amichaelparker/rack-mount/rack_mount_FL_V2.stl

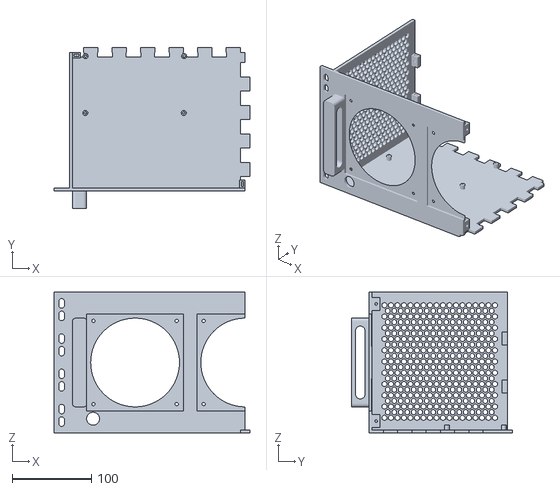
[picture p1: CAD file, 2026-07-29]
rack_mount_FL_V2.stl
247.3 x 203.0 x 177.8
