amichaelparker/rack-mount/rack_mount_GPU_BAR.stl

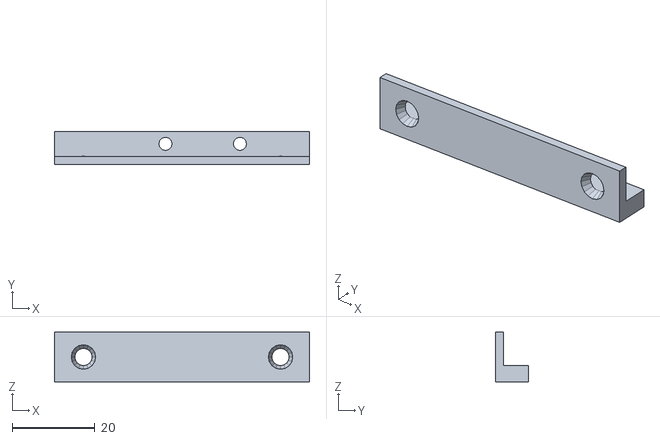
[picture p2: CAD file, 2026-07-29]
rack_mount_GPU_BAR.stl
61.6 x 8.00 x 12.0
