amichaelparker/rack-mount/rack_mount_FL.stl

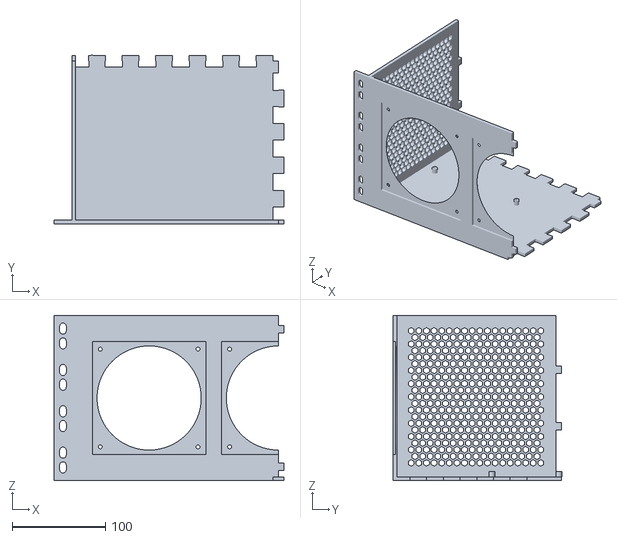
[picture p3: CAD file, 2026-07-29]
rack_mount_FL.stl
247.3 x 181.6 x 177.8
