amichaelparker/rack-mount/rack_mount_jig_L.stl

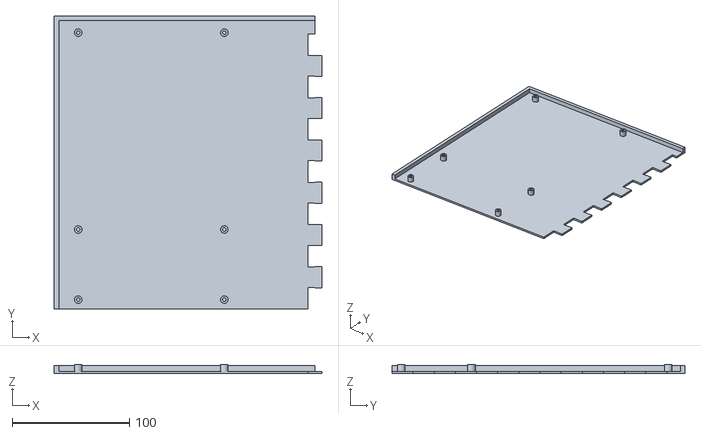
[picture p4: CAD file, 2026-07-29]
rack_mount_jig_L.stl
228.0 x 249.5 x 8.00
