amichaelparker/rack-mount/rack_mount_RL_V2.stl

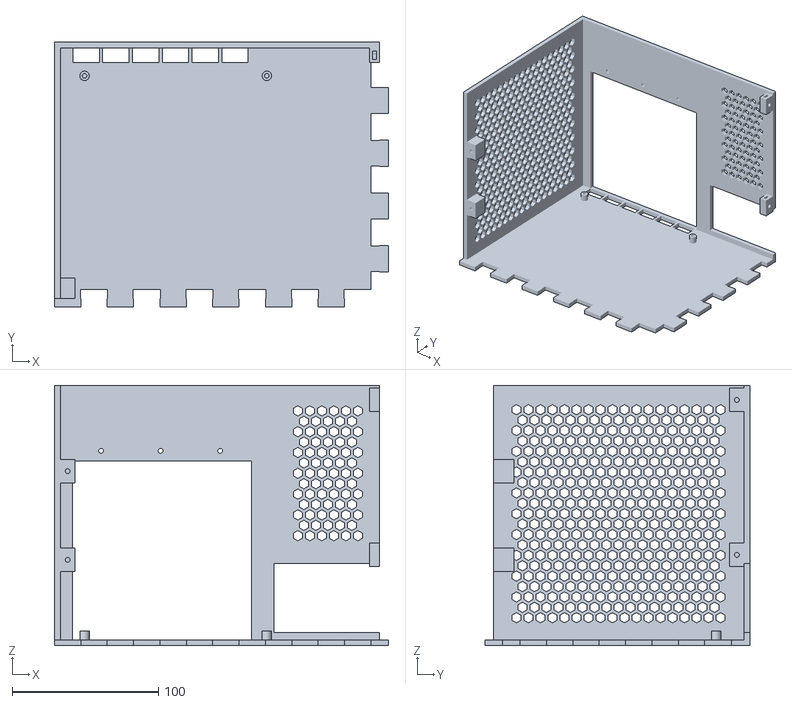
[picture p5: CAD file, 2026-07-29]
rack_mount_RL_V2.stl
228.0 x 181.0 x 177.8
