amichaelparker/rack-mount/rack_mount_jig_R.stl

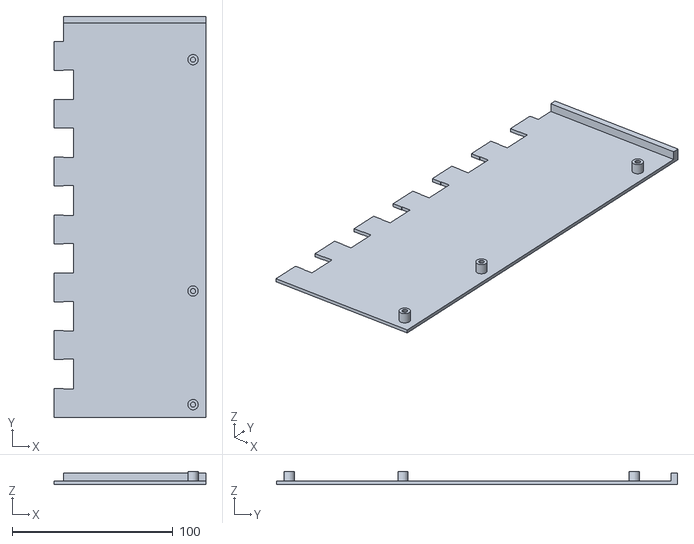
[picture p6: CAD file, 2026-07-29]
rack_mount_jig_R.stl
94.4 x 249.5 x 8.00
