amichaelparker/rack-mount/rack_mount.stl

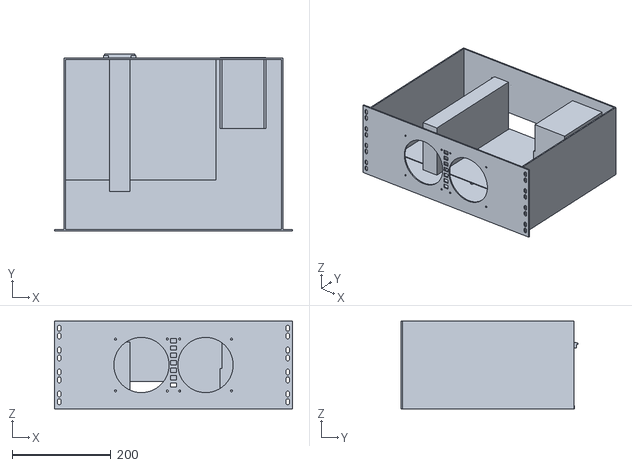
[picture p7: CAD file, 2026-05-23]
rack_mount.stl
482.6 x 358.0 x 177.8
