amichaelparker/rack-mount/(list of files, cad)

Other CAD files:
rack_mount_FR_V2.3mf
rack_mount_FR.stl
rack_mount-RL.stl
rack_mount_gaming.scad
rack_mount copy 2.scad
rack_mount copy.scad
rack_mount_FR_V2.stl
