amichaelparker/rack-mount/(commit log)

2026-05-23 Initial commit: rack mount SCAD files and STL exports
    [rack_frame.scad, rack_mount copy 2.scad, rack_mount copy.scad, rack_mount-RL.stl, rack_mount.scad, rack_mount.stl, rack_mount_FL.stl, rack_mount_FR.stl]
2026-05-24 standoff updates
    [rack_mount.scad]
2026-05-24 separate back panel honeycomb, add second tongue
    [rack_mount.scad]
2026-05-30 Redesign PCIe retention bar to interior mounting
    The exterior retention bar design made it impossible to install a 2-slot
    GPU bracket (upside-down L shape) — you can't thread a wide bracket
    through a bar that spans the outside of all slots.
    New design: retention bar mounts against the inner face of the rear
    panel. Brackets insert from inside the case, face plate goes through the
    slot opening, and the screw tab at the top rests on the bar's inward lip.
    - pcie_retention_bar(): lip now protrudes inward (−Y); 3 mounting holes
    at divider-centre X positions (not slot centres, no overlap); 6 per-slot
    thumbscrew holes; assembly position tray_d−tw−pbar_d instead of tray_d
    - rear_panel_s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
    [rack_mount.scad]
2026-05-30 Fix PCIe bracket thumbscrews to go through lip, not rear wall
    - pbar_lip_d 6→14mm: lip now fully covers ATX bracket tab (~12mm deep)
    - pcie_retention_bar(): per-slot thumbscrew holes now drill in Z (down
    through the inward lip) instead of Y (through the rear wall). Screw
    path: reach in from inside case above → down through lip → into
    bracket screw tab sitting beneath the lip.
    - rear_panel_solid(): removed 6 per-slot wall holes; only the 3 bar
    mounting screws (at divider X positions) go through the rear panel.
    [rack_mount.scad]
2026-05-30 Add floor tab slots for all 6 PCIe slot positions
    Previously only 2 floor tab slots existed (for the GPU's 2-slot bracket).
    Now computes 6 slots — one centred behind each PCIe slot opening — so
    any bracket (GPU, slot cover, or future card) has a floor tab slot.
    Slot centres: pcie_x0 + i*pcie_pitch + pcie_bw/2 for i in 0..5.
    [rack_mount.scad]
2026-05-30 Replace panel/rail tongue-groove joints with M3 bolt bosses
    The old system required all tongue-groove features on 4 seams to engage
    simultaneously, which was extremely difficult with large warped prints.
    New system: each panel/rail seam gets a pair of printed bosses — one side
    has a bolt-head counterbore (accessible from inside the case), the other
    has a hex nut slot open at the top so the nut can be dropped in before
    assembly. Bolt: M3×20 SHCS.
    Assembly sequence: engage floor box joints flat on a table (unchanged),
    then drop M3 hex nuts into nut-trap slots, insert bolts with a hex key
    from inside the case. 7 bolts total (2 front panel + 3 rear panel +
    2 left rail + 2 right rail... actu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
    [rack_mount.scad]
2026-05-30 Fix rear panel bolt boss positions
    - Remove bottom boss (z=6mm): floor box joints already handle seam
    alignment there; the redundant boss was floating near the floor.
    - Clamp top boss center to rack_h - bj_h/2 - 2 (≈167.8mm) so the
    boss top lands 2mm below the case ceiling instead of 2mm above it.
    rp_tab_z now has 2 bosses instead of 3.
    [rack_mount.scad]
2026-05-30 Fix seam bolt joint nut orientation — nuts buried inside piece, not at seam face
    Previously all nut-trap bosses placed the hex nut right at the seam face
    (X=cut_x or Y=cut_y), leaving nothing to keep the nut captive before assembly.
    Swapped all 8 modules so nuts live inside the front/left pieces (FL, FR, RL)
    away from the seam face, and bolt heads are in the rear/right pieces (FR, RR, RL/RR):
    fp_seam_bolt_L: FL ← nut-trap (nut centered at cut_x−3.5, 2.2mm margins)
    fp_seam_bolt_R: FR ← bolt head (counterbore at X=cut_x+bj_w, rotate [0,−90,0])
    rp_seam_bolt_L: RL ← nut-trap (also fixed spurious +2 Z offset bug)
    rp_seam_bolt_R: RR ← bolt head
    lr_seam_bolt_F: FL ← nut-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
    [rack_mount.scad]
2026-05-30 Fix PCIe bracket fitment issues from test print
    board_rear_gap: increase board-to-rear-panel clearance from 1mm → 9mm
    so GPU bracket screw tab has room between the board edge and rear wall
    (retention bar adds ~3mm, rest is bracket tab clearance).
    bkt_cut_h: 125 → 136mm so pcie_oh grows from 111 → 122mm — bracket
    screw tab was hitting the top edge of the opening.
    tab_sd: 5 → 10mm — with the board set back, bracket floor tabs were
    landing just shy of the slot openings; extending the slots forward
    gives them somewhere to land.
    PCIe rear panel opening: replaced 6 individual pcie_bw-wide cuts with
    one continuous 121.92mm-wide opening. The 1.9mm dividers between slots
    are unprintabl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
    [rack_mount.scad]
2026-05-30 Reset ATX standoff positions to exact spec values
    Previous "eyeball" corrections had diverged significantly:
    G/H/J: 75.5mm → 66.04mm from front (-9.5mm)
    F: 210mm → 220.98mm from front (+11mm)
    A/C: 229.5-231mm → 233.68mm (+2.7-4.2mm)
    K/L/M: 4mm → 6.35mm from front (+2.4mm)
    X columns: 17.5-18.5mm → 16.51mm, 143.5mm → 140.97mm, 299.45mm → 298.45mm
    Diagram confirms 10.16mm from IO edge to A/C row = 233.68mm from front,
    matching ATX spec exactly. The corrections were based on a mispositioned
    board model; with board_rear_gap now properly modeled, spec values should
    land correctly.
    [rack_mount.scad]
2026-05-30 Add quick-print standoff test jigs for position verification
    standoff_jig_L(): 2mm base + standoffs for left/middle columns (A,C,G,H,K,L)
    ~151×244mm footprint, ~1-2hr print vs 9hr for a full section.
    standoff_jig_R(): right column (F,J,M) shifted to X=10mm so the 298.45mm
    column fits on the 256mm bed. Align jig left edge at X=288.45mm from
    board left edge.
    Both uncommentable in RENDER SELECTION.
    [rack_mount.scad]
2026-05-30 Rework standoff jigs to snap together at the real cut_x seam
    Both pieces now share a common case-coordinate Y origin and connect with
    the same box joint geometry used on the case floor sections. When assembled,
    the joint encodes the exact 302.45mm X span from board edge to right column —
    no manual alignment needed.
    jig_L: 222×247mm (left+middle columns A,C,G,H,K,L)
    jig_R: ~97×247mm (right column F,J,M, tabs at X=0 for printability)
    [rack_mount.scad]
2026-05-30 Add reference walls to standoff jigs for board seating
    Left wall (jig_L only): inner face at X=bx0, board left edge registers here.
    Rear wall (both pieces, continuous when assembled): inner face at board IO
    edge position, so you seat the board flush and verify all 9 standoffs align.
    Both jigs still fit on the 256mm P1S bed (222×249mm and 94×249mm).
    [rack_mount.scad]
2026-05-31 Fix handles missing from individual sections; anchor J standoff off socket lip
    Handles: front_panel_solid() included both handles but they protrude in -Y,
    outside the FL/FR intersection cubes (which only cover Y≥0). Moved each
    handle outside the intersection in its owning section (FL gets left, FR gets
    right), matching how rack ears and the G standoff are handled.
    J standoff (atx_holes[5]): sits at the lip of the yj_floor_F_sock groove
    (i=4, X≈294–312) in FR. Pulled out of the intersection and into FR's outer
    union so sockets cannot undercut its base; mirrored the G/RL cleanup pattern
    with a precautionary subtraction in RR.
    [rack_mount.scad]
2026-06-01 Loosen nut trap clearance on panel bosses
    bj_nw 5.8→6.1mm, bj_nh 2.6→3.0mm. Previous 0.2–0.3mm clearances
    were too tight for FDM; nuts barely seated. 0.6mm total clearance
    on both dimensions should drop in without force.
    [rack_mount.scad]
2026-07-29 Checkpoint before macOS restore
    [rack_mount_FL.stl, rack_mount_FL_V2.stl, rack_mount_FR.stl, rack_mount_FR_V2.3mf, rack_mount_FR_V2.stl, rack_mount_GPU_BAR.stl, rack_mount_RL_V2.stl, rack_mount_jig_L.stl]
